Kreyl/HogwartsFlasks/README.md

# HogwartsFlasks
Hogwarts Flasks is a project for realictic models of Hogwarts hourglasses for LARPs and events
You may look at them here https://ostranna.ru/hogwartsflasks (text is at Russian, but photoes are international)
