Kreyl/HogwartsFlasks/(list of files, drawings)

Other design files:
PCB/HogwartsFlasksMain.dsn
