Kreyl/HogwartsFlasks/PCB/HogwartsFlasksMain.kicad_pcb

## KiCad design PCB/HogwartsFlasksMain.kicad_pcb (2019-09-29)

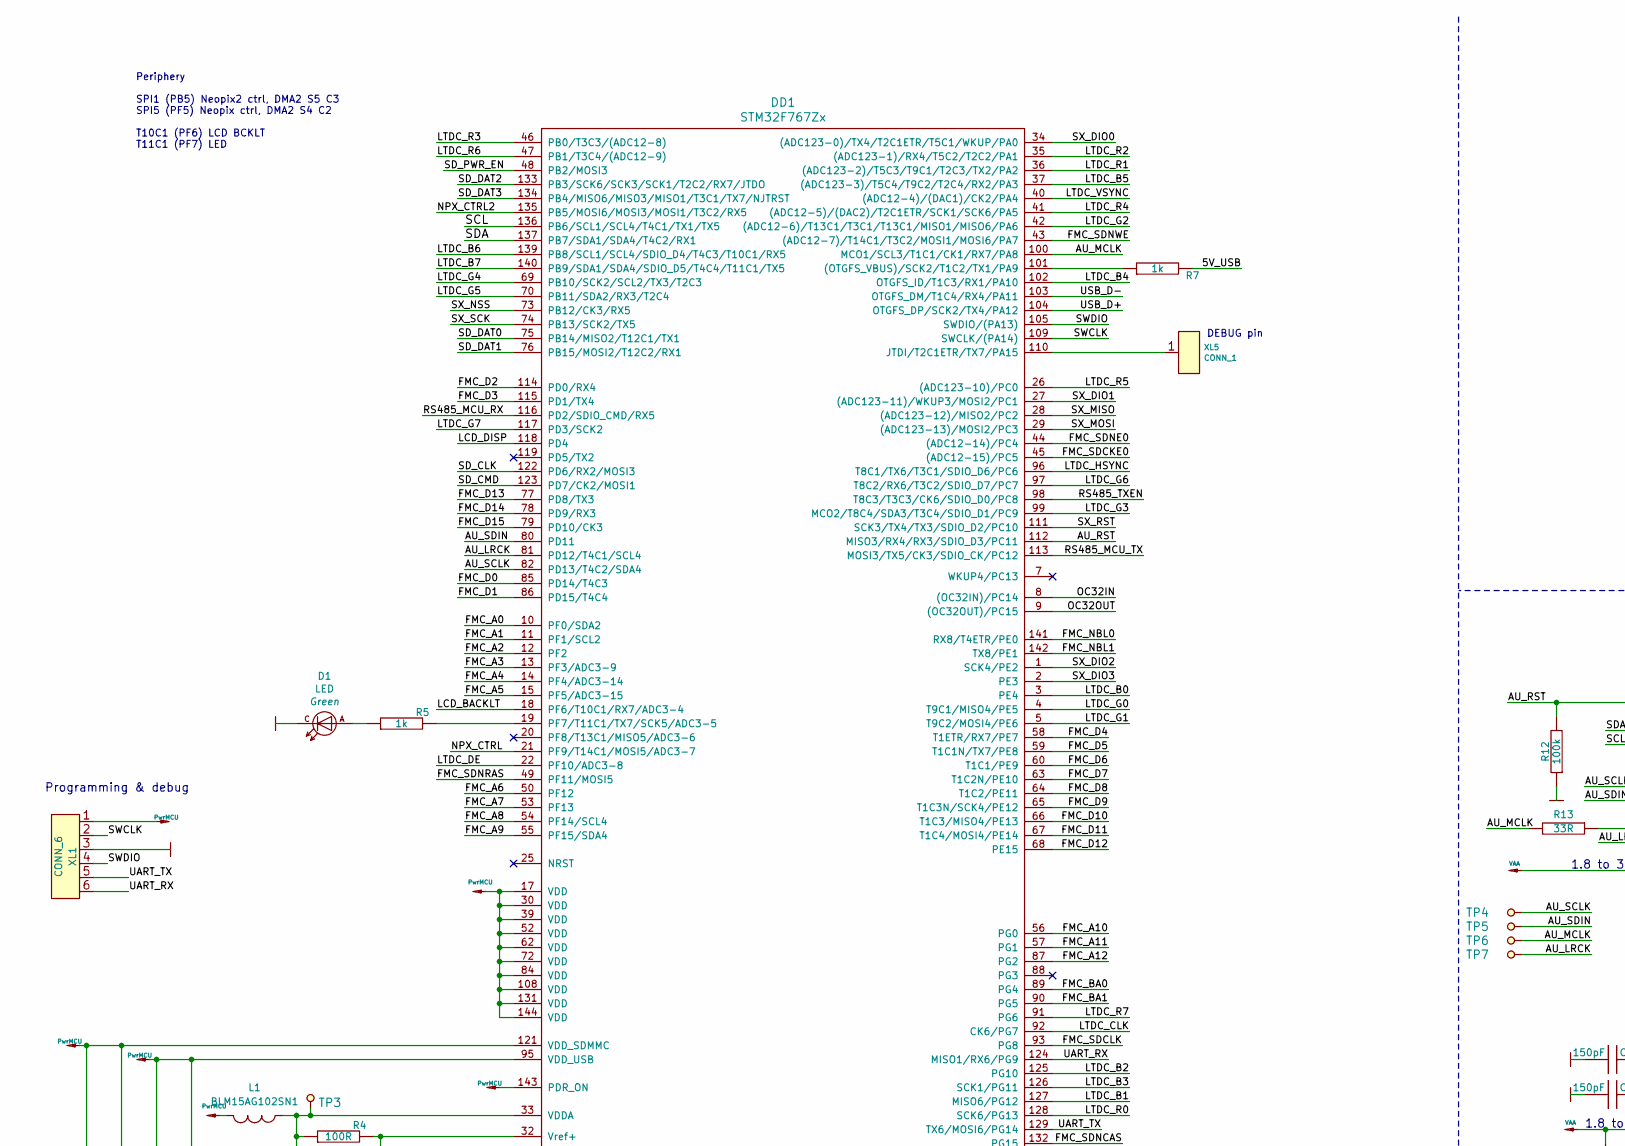
[picture p1: schematic HogwartsFlasksMain.kicad_sch, part in row 1, column 1]

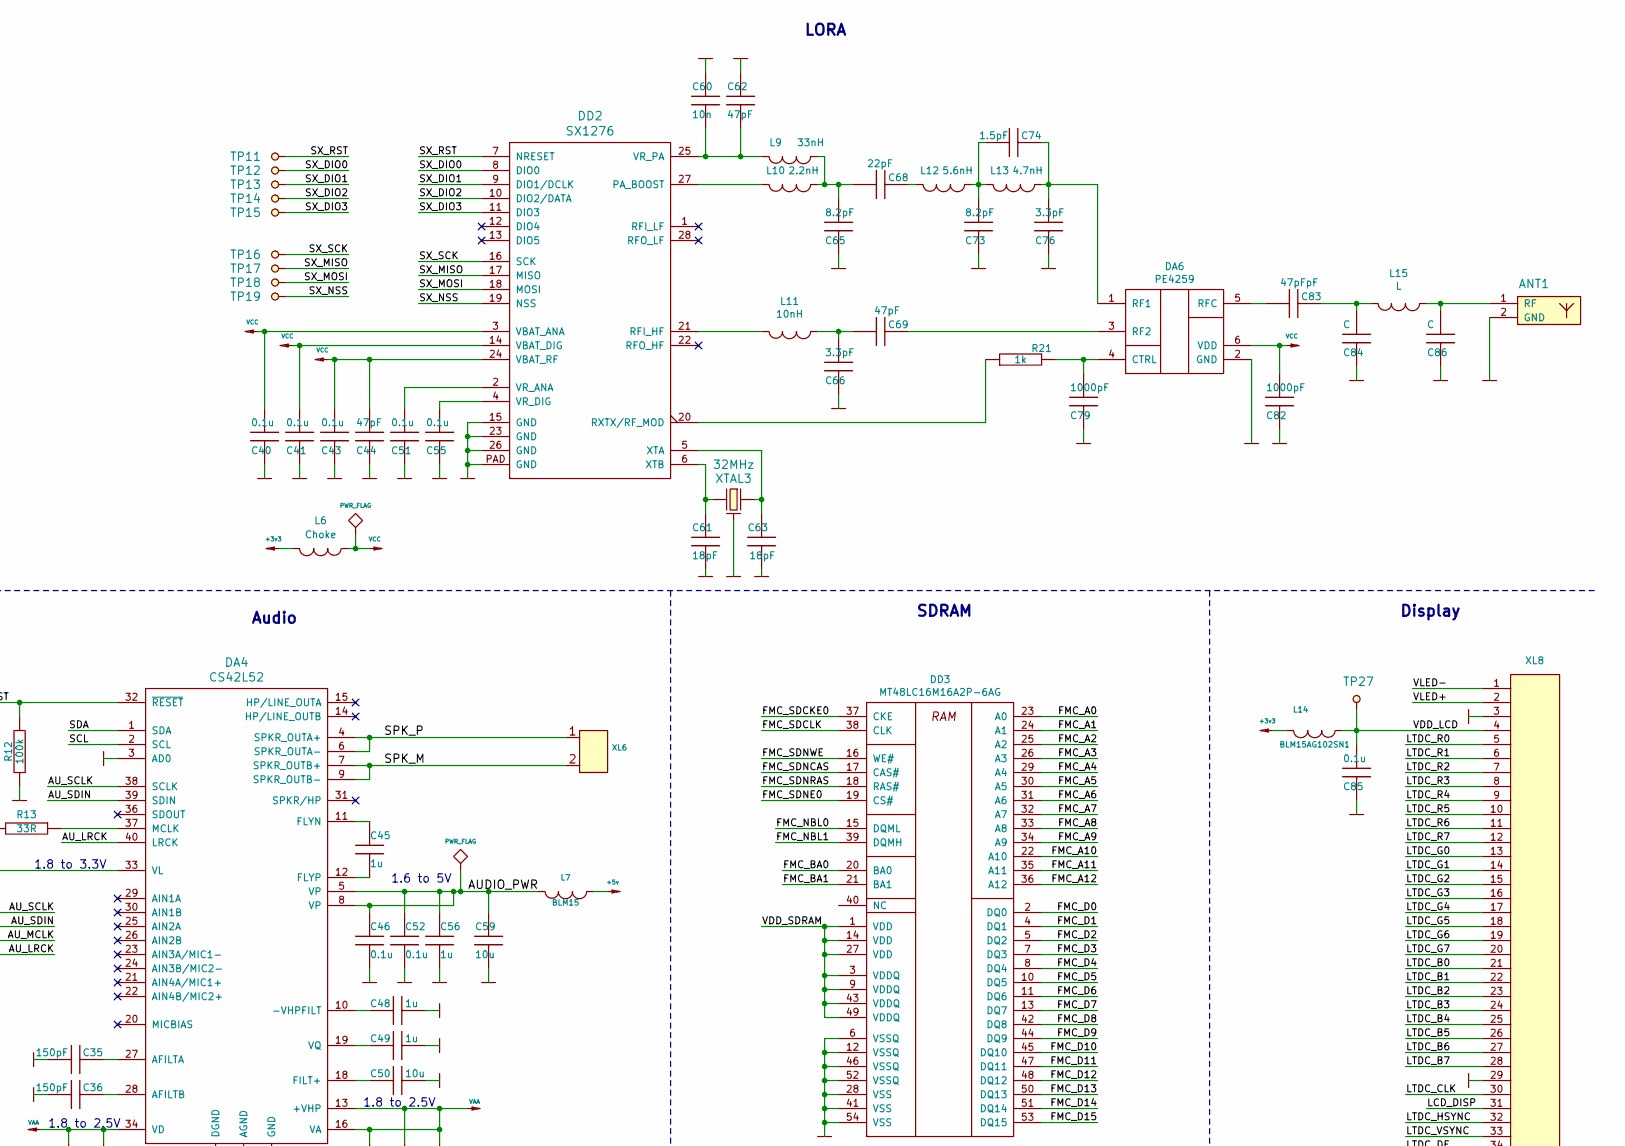
[picture p2: schematic HogwartsFlasksMain.kicad_sch, part in row 1, column 2]

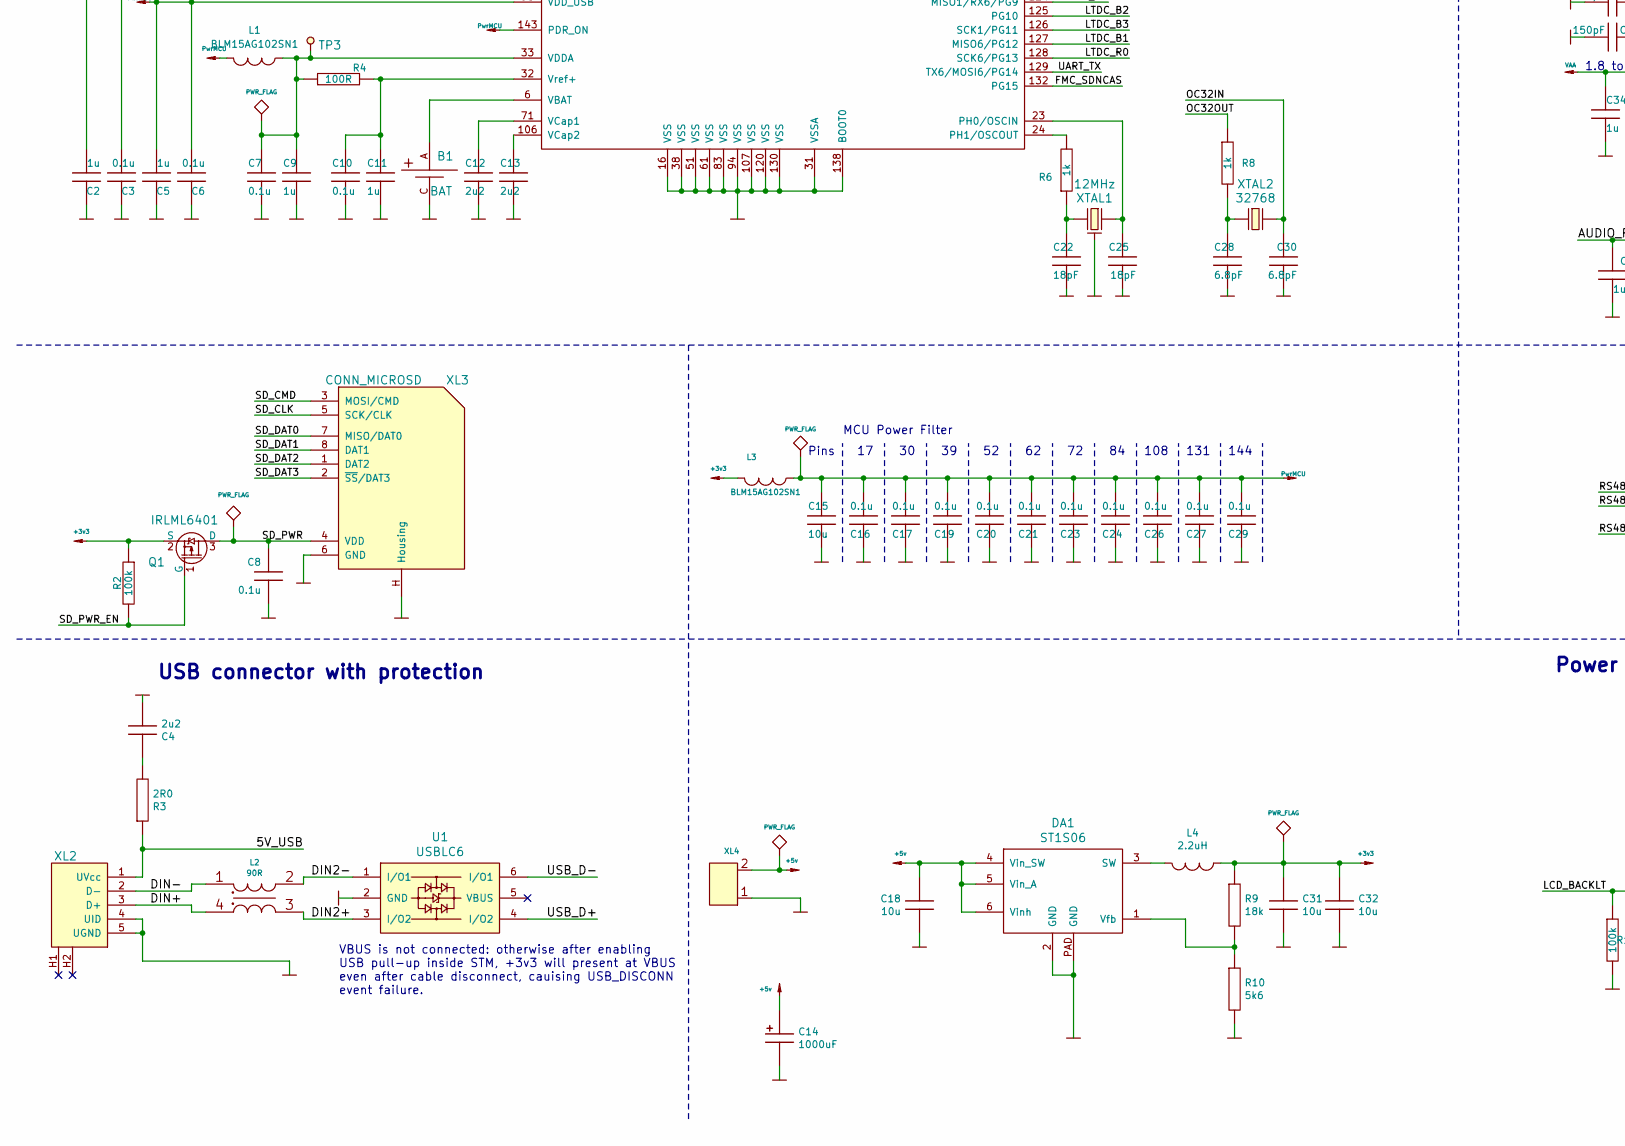
[picture p3: schematic HogwartsFlasksMain.kicad_sch, part in row 2, column 1]

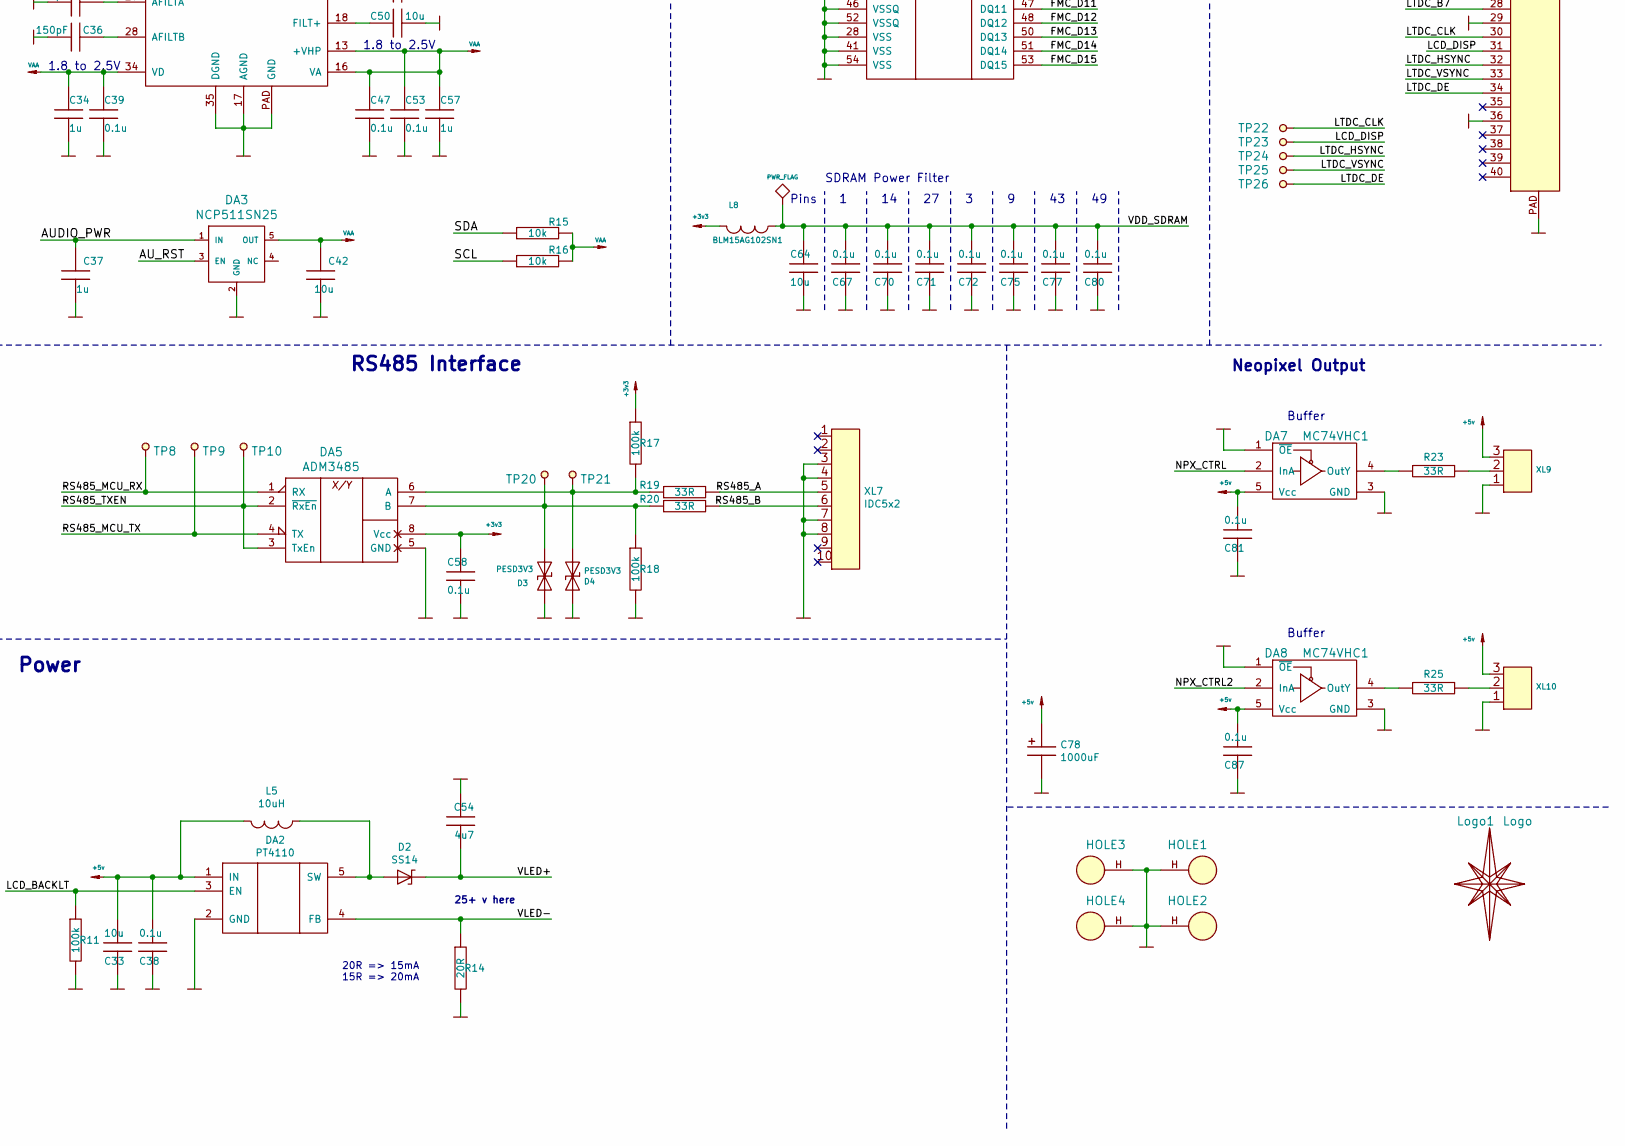
[picture p4: schematic HogwartsFlasksMain.kicad_sch, part in row 2, column 2]

Parts:
ANT1: ANT_GENERAL; ANT_868_IFA_SIMPLEJOY
B1: BAT; BATTERY_CH7410
C2, C5, C9, C11, C34, C37, C45, C48, C49, C56, C57: 1u; CAP_0603_Silks
C3, C6, C7, C8, C10, C16, C17, C19, C20, C21, C23, C24, C26, C27, C29, C38, C39, C46, C47, C52, C53, C58, C67, C70, C71, C72, C75, C77, C80, C81, C85, C87: 0.1u; CAP_0603_Silks
C4, C12, C13: 2u2; CAP_0603_Silks
C14, C78: 1000uF; CAP_10xxR
C15, C18, C31, C32, C33, C42, C50, C59, C64: 10u; CAP_0603_Silks
C22, C25, C61, C63: 18pF; CAP_0603_Silks
C28, C30: 6.8pF; CAP_0603_Silks
C35, C36: 150pF; CAP_0603_Silks
C40, C41, C43, C51, C55: 0.1u; CAP_0402
C44, C62, C69: 47pF; CAP_0402
C54: 4u7; CAP_0805
C60: 10n; CAP_0402
C65, C73: 8.2pF; CAP_0402
C66, C76: 3.3pF; CAP_0402
C68: 22pF; CAP_0402
C74: 1.5pF; CAP_0402
C79, C82: 1000pF; CAP_0402
C83: 47pFpF; CAP_0402
C84, C86: C; CAP_0402
D1: LED; LED_0603
D2: SS14; SMA_DO214AC
D3, D4: PESD3V3; SOD323
DA1: ST1S06; DFN6_3x3
DA2: PT4110; SOT89-5
DA3: NCP511SN25; SOT23-5
DA4: CS42L52; QFN40
DA5: ADM3485; SO8_150MIL
DA6: PE4259; SC70
DA7, DA8: MC74VHC1; SOT23-5
DD1: STM32F767Zx; QFP-144_20x20_Pitch0.5mm
DD2: SX1276; QFN-28_EP_6x6_Pitch0.65mm
DD3: MT48LC16M16A2P-6AG; TSSOP54_400MIL_P08
HOLE1, HOLE2, HOLE3, HOLE4: HOLE_METALLED; Hole3_5_out6mm
L1, L3, L8, L14: BLM15AG102SN1; IND_0402
L2: 90R; DLW21SN
L4: 2.2uH; IND_SRN2512
L5: 10uH; IND_1210_LQH32C
L6: Choke; IND_0402
L7: BLM15; IND_0402
L9: 33nH; IND_0402
L10: 2.2nH; IND_0402
L11: 10nH; IND_0402
L12: 5.6nH; IND_0402
L13: 4.7nH; IND_0402
L15: L; IND_0402
Logo1: Logo; Ostranna_12d7_10d1
Q1: IRLML6401; SOT23-3
R2, R11, R12, R17, R18: 100k; RES_0603
R3: 2R0; RES_0603
R4: 100R; RES_0603
R5, R6, R7, R8, R21: 1k; RES_0603
R9: 18k; RES_0603
R10: 5k6; RES_0603
R13, R19, R20, R23, R25: 33R; RES_0603
R14: 20R; RES_0603
R15, R16: 10k; RES_0603
TP3, TP4, TP5, TP6, TP7, TP8, TP9, TP10, TP11, TP12, TP13, TP14, TP15, TP16, TP17, TP18, TP19, TP20, TP21, TP22, TP23, TP24, TP25, TP26, TP27: TESTPOINT; TESTPOINT_1MM
U1: USBLC6; SOT23-6
XL1: CONN_6; PLS-6_LOCK
XL2: USB_MICRO_2H; USBmicro_MOLEX_1050170001
XL3: CONN_MICROSD; MICROSD_CAP_FIX05A
XL4: CONN_2; TermiBlockHeader_508_x2_R
XL5: CONN_1; PLS-1Rnd
XL6: CONN_2; W02_Pitch_2d54
XL7: IDC5x2; IDC-Header_2x5_P2.54mm_Vertical
XL8: CONN_40; FFC_0d5x40_flip
XL9, XL10: CONN_3; SLD_3_2D5
XTAL1: 12MHz; 03225C4
XTAL2: 32768; 03215C2
XTAL3: 32MHz; 03225C4

Connections:
+3v3: C31.1, C32.1, C58.2, DA5.8 (Vcc), L3.2, L4.2, L6.2, L8.2, L14.2, Q1.2 (S), R2.1, R9.1, R17.1
+5v: C14.1, C18.1, C33.1, C38.1, C78.1, C81.1, C87.1, DA1.4 (Vin_SW), DA1.5 (Vin_A), DA1.6 (Vinh), DA2.1 (IN), DA7.5 (Vcc), DA8.5 (Vcc), L5.1, L7.2, XL4.2 (PM), XL9.3, XL10.3
/5V_USB: R3.1, R7.2, XL2.1 (UVcc)
/AUDIO_PWR: C37.1, C46.1, C52.1, C56.1, C59.2, DA3.1 (IN), DA4.5 (VP), DA4.8 (VP), L7.1
/AU_LRCK: DA4.40 (LRCK), DD1.81 (PD12/T4C1/SCL4), TP7.1
/AU_MCLK: DD1.100 (MCO1/SCL3/T1C1/CK1/RX7/PA8), R13.2, TP6.1
/AU_RST: DA3.3 (EN), DA4.32 (~RESET), DD1.112 (MISO3/RX4/RX3/SDIO_D3/PC11), R12.2
/AU_SCLK: DA4.38 (SCLK), DD1.82 (PD13/T4C2/SDA4), TP4.1
/AU_SDIN: DA4.39 (SDIN), DD1.80 (PD11), TP5.1
/DIN2+: L2.3, U1.3 (I/O2)
/DIN2-: L2.2, U1.1 (I/O1)
/DIN+: L2.4, XL2.3 (D+)
/DIN-: L2.1, XL2.2 (D-)
/FMC_A0: DD1.10 (PF0/SDA2), DD3.23 (A0)
/FMC_A1: DD1.11 (PF1/SCL2), DD3.24 (A1)
/FMC_A2: DD1.12 (PF2), DD3.25 (A2)
/FMC_A3: DD1.13 (PF3/ADC3-9), DD3.26 (A3)
/FMC_A4: DD1.14 (PF4/ADC3-14), DD3.29 (A4)
/FMC_A5: DD1.15 (PF5/ADC3-15), DD3.30 (A5)
/FMC_A6: DD1.50 (PF12), DD3.31 (A6)
/FMC_A7: DD1.53 (PF13), DD3.32 (A7)
/FMC_A8: DD1.54 (PF14/SCL4), DD3.33 (A8)
/FMC_A9: DD1.55 (PF15/SDA4), DD3.34 (A9)
/FMC_A10: DD1.56 (PG0), DD3.22 (A10)
/FMC_A11: DD1.57 (PG1), DD3.35 (A11)
/FMC_A12: DD1.87 (PG2), DD3.36 (A12)
/FMC_BA0: DD1.89 (PG4), DD3.20 (BA0)
/FMC_BA1: DD1.90 (PG5), DD3.21 (BA1)
/FMC_D0: DD1.85 (PD14/T4C3), DD3.2 (DQ0)
/FMC_D1: DD1.86 (PD15/T4C4), DD3.4 (DQ1)
/FMC_D2: DD1.114 (PD0/RX4), DD3.5 (DQ2)
/FMC_D3: DD1.115 (PD1/TX4), DD3.7 (DQ3)
/FMC_D4: DD1.58 (T1ETR/RX7/PE7), DD3.8 (DQ4)
/FMC_D5: DD1.59 (T1C1N/TX7/PE8), DD3.10 (DQ5)
/FMC_D6: DD1.60 (T1C1/PE9), DD3.11 (DQ6)
/FMC_D7: DD1.63 (T1C2N/PE10), DD3.13 (DQ7)
/FMC_D8: DD1.64 (T1C2/PE11), DD3.42 (DQ8)
/FMC_D9: DD1.65 (T1C3N/SCK4/PE12), DD3.44 (DQ9)
/FMC_D10: DD1.66 (T1C3/MISO4/PE13), DD3.45 (DQ10)
/FMC_D11: DD1.67 (T1C4/MOSI4/PE14), DD3.47 (DQ11)
/FMC_D12: DD1.68 (PE15), DD3.48 (DQ12)
/FMC_D13: DD1.77 (PD8/TX3), DD3.50 (DQ13)
/FMC_D14: DD1.78 (PD9/RX3), DD3.51 (DQ14)
/FMC_D15: DD1.79 (PD10/CK3), DD3.53 (DQ15)
/FMC_NBL0: DD1.141 (RX8/T4ETR/PE0), DD3.15 (DQML)
/FMC_NBL1: DD1.142 (TX8/PE1), DD3.39 (DQMH)
/FMC_SDCKE0: DD1.45 ((ADC12-15)/PC5), DD3.37 (CKE)
/FMC_SDCLK: DD1.93 (PG8), DD3.38 (CLK)
/FMC_SDNCAS: DD1.132 (PG15), DD3.17 (CAS#)
/FMC_SDNE0: DD1.44 ((ADC12-14)/PC4), DD3.19 (CS#)
/FMC_SDNRAS: DD1.49 (PF11/MOSI5), DD3.18 (RAS#)
/FMC_SDNWE: DD1.43 ((ADC12-7)/T14C1/T3C2/MOSI1/MOSI6/PA7), DD3.16 (WE#)
/LCD_BACKLT: DA2.3 (EN), DD1.18 (PF6/T10C1/RX7/ADC3-4), R11.1
/LCD_DISP: DD1.118 (PD4), TP23.1, XL8.31
/LTDC_B0: DD1.3 (PE4), XL8.21
/LTDC_B1: DD1.127 (MISO6/PG12), XL8.22
/LTDC_B2: DD1.125 (PG10), XL8.23
/LTDC_B3: DD1.126 (SCK1/PG11), XL8.24
/LTDC_B4: DD1.102 (OTGFS_ID/T1C3/RX1/PA10), XL8.25
/LTDC_B5: DD1.37 ((ADC123-3)/T5C4/T9C2/T2C4/RX2/PA3), XL8.26
/LTDC_B6: DD1.139 (PB8/SCL1/SCL4/SDIO_D4/T4C3/T10C1/RX5), XL8.27
/LTDC_B7: DD1.140 (PB9/SDA1/SDA4/SDIO_D5/T4C4/T11C1/TX5), XL8.28
/LTDC_CLK: DD1.92 (CK6/PG7), TP22.1, XL8.30
/LTDC_DE: DD1.22 (PF10/ADC3-8), TP26.1, XL8.34
/LTDC_G0: DD1.4 (T9C1/MISO4/PE5), XL8.13
/LTDC_G1: DD1.5 (T9C2/MOSI4/PE6), XL8.14
/LTDC_G2: DD1.42 ((ADC12-6)/T13C1/T3C1/T13C1/MISO1/MISO6/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), XL8.15
/LTDC_G3: DD1.99 (MCO2/T8C4/SDA3/T3C4/SDIO_D1/PC9), XL8.16
/LTDC_G4: DD1.69 (PB10/SCK2/SCL2/TX3/T2C3), XL8.17
/LTDC_G5: DD1.70 (PB11/SDA2/RX3/T2C4), XL8.18
/LTDC_G6: DD1.97 (T8C2/RX6/T3C2/SDIO_D7/PC7), XL8.19
/LTDC_G7: DD1.117 (PD3/SCK2), XL8.20
/LTDC_HSYNC: DD1.96 (T8C1/TX6/T3C1/SDIO_D6/PC6), TP24.1, XL8.32
/LTDC_R0: DD1.128 (SCK6/PG13), XL8.5
/LTDC_R1: DD1.36 ((ADC123-2)/T5C3/T9C1/T2C3/TX2/PA2), XL8.6
/LTDC_R2: DD1.35 ((ADC123-1)/RX4/T5C2/T2C2/PA1), XL8.7
/LTDC_R3: DD1.46 (PB0/T3C3/(ADC12-8)), XL8.8
/LTDC_R4: DD1.41 ((ADC12-5)/(DAC2)/T2C1ETR/SCK1/SCK6/PA5), XL8.9
/LTDC_R5: DD1.26 ((ADC123-10)/PC0), XL8.10
/LTDC_R6: DD1.47 (PB1/T3C4/(ADC12-9)), XL8.11
/LTDC_R7: DD1.91 (PG6), XL8.12
/LTDC_VSYNC: DD1.40 ((ADC12-4)/(DAC1)/CK2/PA4), TP25.1, XL8.33
/NPX_CTRL: DA7.2 (InA), DD1.21 (PF9/T14C1/MOSI5/ADC3-7)
/NPX_CTRL2: DA8.2 (InA), DD1.135 (PB5/MOSI6/MOSI3/MOSI1/T3C2/RX5)
/OC32IN: C30.2, DD1.8 ((OC32IN)/PC14), XTAL2.2
/OC32OUT: DD1.9 ((OC32OUT)/PC15), R8.1
/RS485_A: R19.2, XL7.5
/RS485_B: R20.2, XL7.6
/RS485_MCU_RX: DA5.1 (RX), DD1.116 (PD2/SDIO_CMD/RX5), TP8.1
/RS485_MCU_TX: DA5.4 (TX), DD1.113 (MOSI3/TX5/CK3/SDIO_CK/PC12), TP9.1
/RS485_TXEN: DA5.2 (~RxEn), DA5.3 (TxEn), DD1.98 (T8C3/T3C3/CK6/SDIO_D0/PC8), TP10.1
/SCL: DA4.2 (SCL), DD1.136 (PB6/SCL1/SCL4/T4C1/TX1/TX5), R16.1
/SDA: DA4.1 (SDA), DD1.137 (PB7/SDA1/SDA4/T4C2/RX1), R15.1
/SD_CLK: DD1.122 (PD6/RX2/MOSI3), XL3.5 (SCK/CLK)
/SD_CMD: DD1.123 (PD7/CK2/MOSI1), XL3.3 (MOSI/CMD)
/SD_DAT0: DD1.75 (PB14/MISO2/T12C1/TX1), XL3.7 (MISO/DAT0)
/SD_DAT1: DD1.76 (PB15/MOSI2/T12C2/RX1), XL3.8 (DAT1)
/SD_DAT2: DD1.133 (PB3/SCK6/SCK3/SCK1/T2C2/RX7/JTDO), XL3.1 (DAT2)
/SD_DAT3: DD1.134 (PB4/MISO6/MISO3/MISO1/T3C1/TX7/NJTRST), XL3.2 (~SS~/DAT3)
/SD_PWR: C8.1, Q1.3 (D), XL3.4 (VDD)
/SD_PWR_EN: DD1.48 (PB2/MOSI3), Q1.1 (G), R2.2
/SPK_M: DA4.7 (SPKR_OUTB+), DA4.9 (SPKR_OUTB-), XL6.2 (PM)
/SPK_P: DA4.4 (SPKR_OUTA+), DA4.6 (SPKR_OUTA-), XL6.1
/SWCLK: DD1.109 (SWCLK/(PA14)), XL1.2
/SWDIO: DD1.105 (SWDIO/(PA13)), XL1.4
/SX_DIO0: DD1.34 ((ADC123-0)/TX4/T2C1ETR/T5C1/WKUP/PA0), DD2.8 (DIO0), TP12.1
/SX_DIO1: DD1.27 ((ADC123-11)/WKUP3/MOSI2/PC1), DD2.9 (DIO1/DCLK), TP13.1
/SX_DIO2: DD1.1 (SCK4/PE2), DD2.10 (DIO2/DATA), TP14.1
/SX_DIO3: DD1.2 (PE3), DD2.11 (DIO3), TP15.1
/SX_MISO: DD1.28 ((ADC123-12)/MISO2/PC2), DD2.17 (MISO), TP17.1
/SX_MOSI: DD1.29 ((ADC123-13)/MOSI2/PC3), DD2.18 (MOSI), TP18.1
/SX_NSS: DD1.73 (PB12/CK3/RX5), DD2.19 (NSS), TP19.1
/SX_RST: DD1.111 (SCK3/TX4/TX3/SDIO_D2/PC10), DD2.7 (NRESET), TP11.1
/SX_SCK: DD1.74 (PB13/SCK2/TX5), DD2.16 (SCK), TP16.1
/UART_RX: DD1.124 (MISO1/RX6/PG9), XL1.6
/UART_TX: DD1.129 (TX6/MOSI6/PG14), XL1.5
/USB_D+: DD1.104 (OTGFS_DP/SCK2/TX4/PA12), U1.4 (I/O2)
/USB_D-: DD1.103 (OTGFS_DM/T1C4/RX4/PA11), U1.6 (I/O1)
/VDD_LCD: C85.1, L14.1, TP27.1, XL8.4
/VDD_SDRAM: C64.2, C67.1, C70.1, C71.1, C72.1, C75.1, C77.1, C80.1, DD3.1 (VDD), DD3.3 (VDDQ), DD3.9 (VDDQ), DD3.14 (VDD), DD3.27 (VDD), DD3.43 (VDDQ), DD3.49 (VDDQ), L8.1
unnamed: ANT1.1 (RF), C86.1, L15.2
unnamed: B1.A, DD1.6 (VBAT)
unnamed 122: XL2.H1; also elsewhere on the board
unnamed: C4.1, R3.2
unnamed: C7.2, C9.2, DD1.33 (VDDA), L1.1, R4.1, TP3.1
unnamed: C10.2, C11.2, DD1.32 (Vref+), R4.2
unnamed: C12.2, DD1.71 (VCap1)
unnamed: C13.2, DD1.106 (VCap2)
unnamed: C22.1, R6.1, XTAL1.2
unnamed: C25.1, DD1.23 (PH0/OSCIN), XTAL1.1
unnamed: C28.2, R8.2, XTAL2.1
unnamed: C35.2, DA4.27 (AFILTA)
unnamed: C36.2, DA4.28 (AFILTB)
unnamed: C45.1, DA4.11 (FLYN)
unnamed: C45.2, DA4.12 (FLYP)
unnamed: C48.2, DA4.10 (-VHPFILT)
unnamed: C49.2, DA4.19 (VQ)
unnamed: C50.2, DA4.18 (FILT+)
unnamed: C51.1, DD2.2 (VR_ANA)
unnamed: C55.1, DD2.4 (VR_DIG)
unnamed: C60.1, C62.1, DD2.25 (VR_PA), L9.1
unnamed: C61.1, DD2.6 (XTB), XTAL3.2
unnamed: C63.1, DD2.5 (XTA), XTAL3.1
unnamed: C65.1, C68.2, L9.2, L10.2
unnamed: C66.1, C69.2, L11.2
unnamed: C68.1, L12.1
unnamed: C69.1, DA6.3 (RF2)
unnamed: C73.1, C74.2, L12.2, L13.1
unnamed: C74.1, C76.1, DA6.1 (RF1), L13.2
unnamed: C79.1, DA6.4 (CTRL), R21.2
unnamed: C83.1, C84.1, L15.1
unnamed: C83.2, DA6.5 (RFC)
unnamed: D1.A, R5.1
unnamed: D2.A, DA2.5 (SW), L5.2
unnamed: D3.C, DA5.7 (B), R18.1, R20.1, TP20.1
unnamed: D4.C, DA5.6 (A), R17.2, R19.1, TP21.1
unnamed: DA1.1 (Vfb), R9.2, R10.1
unnamed: DA1.3 (SW), L4.1
unnamed: DA4.37 (MCLK), R13.1
unnamed: DA7.4 (OutY), R23.2
unnamed: DA8.4 (OutY), R25.2
unnamed: DD1.19 (PF7/T11C1/TX7/SCK5/ADC3-5), R5.2
unnamed: DD1.24 (PH1/OSCOUT), R6.2
unnamed: DD1.101 ((OTGFS_VBUS)/SCK2/T1C2/TX1/PA9), R7.1
unnamed: DD1.110 (JTDI/T2C1ETR/TX7/PA15), XL5.1
unnamed: DD2.20 (RXTX/RF_MOD), R21.1
unnamed: DD2.21 (RFI_HF), L11.1
unnamed: DD2.27 (PA_BOOST), L10.1
unnamed: R23.1, XL9.2 (PM)
unnamed: R25.1, XL10.2 (PM)
PwrMCU: C2.1, C3.1, C5.1, C6.1, C15.2, C16.1, C17.1, C19.1, C20.1, C21.1, C23.1, C24.1, C26.1, C27.1, C29.1, DD1.17 (VDD), DD1.30 (VDD), DD1.39 (VDD), DD1.52 (VDD), DD1.62 (VDD), DD1.72 (VDD), DD1.84 (VDD), DD1.95 (VDD_USB), DD1.108 (VDD), DD1.121 (VDD_SDMMC), DD1.131 (VDD), DD1.143 (PDR_ON), DD1.144 (VDD), L1.2, L3.1, XL1.1
VAA: C34.1, C39.1, C42.1, C47.1, C53.1, C57.1, DA3.5 (OUT), DA4.13 (+VHP), DA4.16 (VA), DA4.33 (VL), DA4.34 (VD), R15.2, R16.2
VCC: C40.1, C41.1, C43.1, C44.1, C82.1, DA6.6 (VDD), DD2.3 (VBAT_ANA), DD2.14 (VBAT_DIG), DD2.24 (VBAT_RF), L6.1

Notes on the sheet:
Programming & debug
Periphery SPI1 (PB5) Neopix2 ctrl, DMA2 S5 C3 SPI5 (PF5) Neopix ctrl, DMA2 S4 C2 T10C1 (PF6) LCD BCKLT T11C1 (PF7) LED
USB connector with protection
VBUS is not connected: otherwise after enabling USB pull-up inside STM, +3v3 will present at VBUS even after cable disconnect, cauising USB_DISCONN event failure.
Pins
MCU Power Filter
108
131
DEBUG pin
144
1.8 to 3.3V
1.8 to 2.5V
Power
Audio
20R => 15mA 15R => 20mA
1.6 to 5V
25+ v here
RS485 Interface
LORA
SDRAM Power Filter
SDRAM
Neopixel Output
Buffer
Display

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
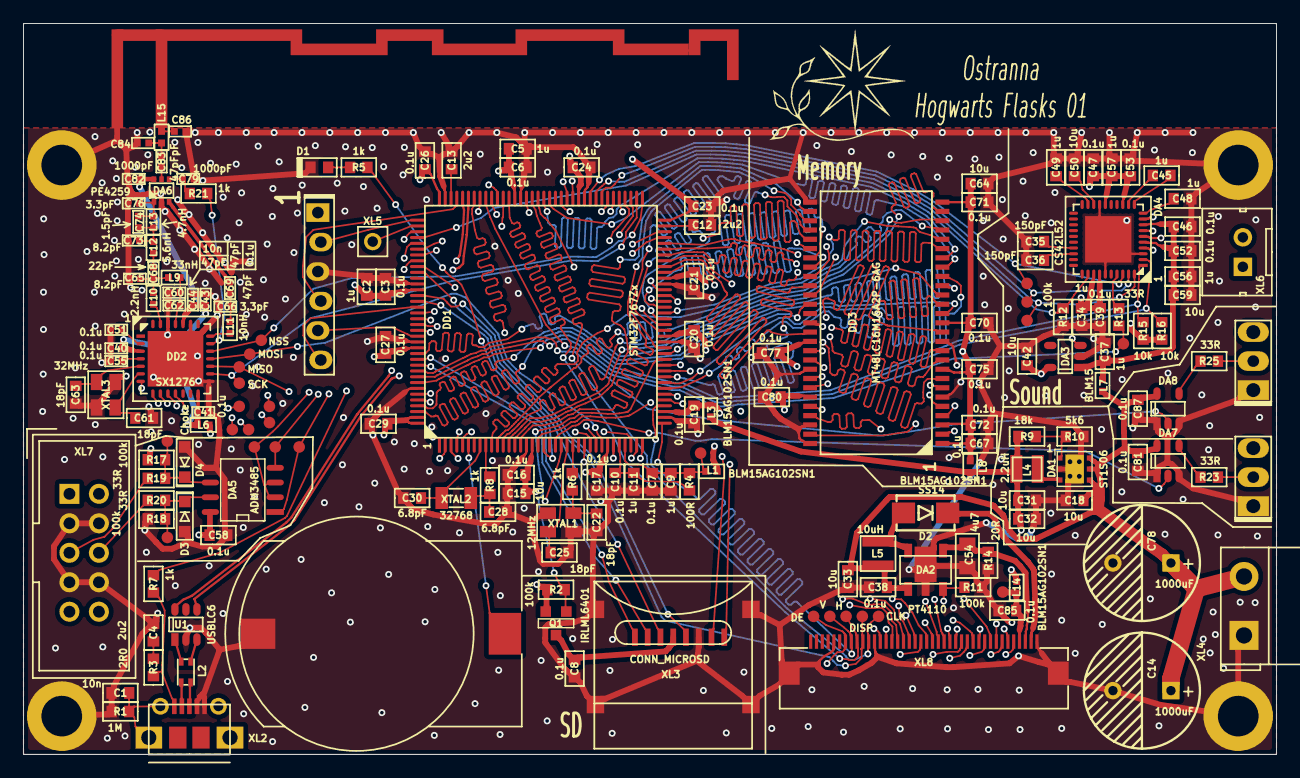
[picture p5: board HogwartsFlasksMain.kicad_pcb from above]

Board: 4 copper layers, 108.0 x 63.0 mm, 187 parts (0 on the bottom side), 176 nets.

Other parts of the board:
C1: 10n; CAP_0603_Silks
R1: 1M; RES_0603

Their connections:
unnamed 122: C1.2, R1.1; also elsewhere on the board
