Kreyl/HogwartsFlasks/FlasksMain_fw/main.cpp

#include "hal.h"
#include "MsgQ.h"
#include "kl_lib.h"
#include "Sequences.h"
#include "uart.h"
#include "shell.h"
#include "led.h"
#include "ws2812b.h"
#include "kl_sd.h"
#include "kl_fs_utils.h"
#include "kl_time.h"
#include "Mirilli.h"
#include "sdram.h"
#include "radio_lvl1.h"
#include "FlasksSnd.h"
#include "Points.h"

#if 1 // =============== Defines ================
// Forever
EvtMsgQ_t<EvtMsg_t, MAIN_EVT_Q_LEN> EvtQMain;
static const UartParams_t CmdUartParams(115200, CMD_UART_PARAMS);
CmdUart_t Uart{CmdUartParams};

static const UartParams_t RS485Params(19200, RS485_PARAMS);
HostUart485_t RS485{RS485Params, RS485_TXEN};

static void ITask();
static void OnCmd(Shell_t *PShell);

LedBlinker_t Led{LED_PIN};
TmrKL_t TmrBckgStop{TIME_MS2I(7200), evtIdBckgStop, tktOneShot};
#endif

#if 1 // ========= Lume =========
static void IndicateNewSecond();
Color_t ClrH(0, 0, 255);
Color_t ClrM(0, 255, 0);

class Hypertime_t {
public:
    void ConvertFromTime() {
        // Hours
        int32_t FH = Time.Curr.H;
        if(FH > 11) FH -= 12;
        if(H != FH) {
            H = FH;
            NewH = true;
        }
        // Minutes
        int32_t S = Time.Curr.M * 60 + Time.Curr.S;
        int32_t FMin = S / 150;    // 150s in one hyperminute (== 2.5 minutes)
        if(M != FMin) {
            M = FMin;
            NewM = true;
        }
    }
    int32_t H, M;
    bool NewH = true, NewM = true;
} Hypertime;
#endif

void main() {
    // ==== Setup clock ====
    Clk.SetCoreClk160MHz();
    Clk.Setup48Mhz();
    // SAI clock: PLLSAI1 Q
    Clk.SetPllSai1QDiv(8, 1); // Q = 2 * 96 / 8 = 24; 24/1 = 24
    Clk.SetSai2ClkSrc(saiclkPllSaiQ);
    FLASH->ACR |= FLASH_ACR_ARTEN; // Enable ART accelerator
    Clk.UpdateFreqValues();

    // ==== Init OS ====
    halInit();
    chSysInit();
    // ==== Init Hard & Soft ====
    SdramInit();
    EvtQMain.Init();
    Uart.Init();
    Printf("\r%S %S\r\n", APP_NAME, XSTRINGIFY(BUILD_TIME));
    Clk.PrintFreqs();

    // Debug LED
    Led.Init();
    Led.StartOrRestart(lsqIdle);

    SD.Init();

    // Time
    BackupSpc::EnableAccess();
    ClrH.DWord32 = BackupSpc::ReadRegister(BCKP_REG_CLRH_INDX);
    ClrM.DWord32 = BackupSpc::ReadRegister(BCKP_REG_CLRM_INDX);
    InitMirilli();
    Time.Init();

    Sound.Init();
    Sound.SetupVolume(81);
    Sound.SetSlotVolume(BACKGROUND_SLOT, 2048);
    Sound.PlayAlive();
    chThdSleepMilliseconds(1535);
    uint32_t Volume = BackupSpc::ReadRegister(BCKP_REG_VOLUME_INDX);
    if(Volume > 100) Volume = 100;
    Sound.SetupVolume(Volume);

    // Points
    Npx.Init();
    Points::Init();
    RS485.Init();

    Radio.Init();

    // ==== Main cycle ====
    ITask();
}

// Sum is used as simple CRC
void SendScreenCmd(Points::Values v) {
    RS485.SendBroadcast(0, 1, "Set", "%d %d %d %d %d", v.grif, v.slyze, v.rave, v.huff, v.Sum());
}

void SendScreenCmdHide() {
    RS485.SendBroadcast(0, 1, "Hide");
}

__noreturn
void ITask() {
    while(true) {
        EvtMsg_t Msg = EvtQMain.Fetch(TIME_INFINITE);
        switch(Msg.ID) {
            case evtIdUartCmdRcvd:
                Led.StartOrRestart(lsqCmd);
                while(((CmdUart_t*)Msg.Ptr)->TryParseRxBuff() == retvOk) OnCmd((Shell_t*)((CmdUart_t*)Msg.Ptr));
                break;

            case evtIdEverySecond:
                IndicateNewSecond();
                break;

            // Points
            case evtIdPointsSet:
                Sound.PlayBackgroundIfNotYet();
                TmrBckgStop.StartOrRestart();
                break;
            case evtIdPointsAdd:
                Sound.PlayAdd(Msg.Value);
                Sound.PlayBackgroundIfNotYet();
                TmrBckgStop.StartOrRestart();
                SendScreenCmd(Points::GetDisplayed());
                break;
            case evtIdPointsRemove:
                Sound.PlayRemove(Msg.Value);
                Sound.PlayBackgroundIfNotYet();
                TmrBckgStop.StartOrRestart();
                SendScreenCmd(Points::GetDisplayed());
                break;
            case evtIdPointsHide:
                SendScreenCmdHide();
                break;
            case evtIdPointsShow:
                SendScreenCmd(Points::GetDisplayed());
                break;

            case evtIdBckgStop:
                Sound.StopBackground();
                break;

            default: break;
        } // switch
    } // while true
}

#if 1 // ============================== Lume ===================================
void IndicateNewSecond() {
    chSysLock();
    Time.GetDateTime();
    Hypertime.ConvertFromTime();
    ResetColorsToOffState(ClrH, ClrM);

    SetTargetClrH(Hypertime.H, ClrH);
    if(Hypertime.M == 0) {
        SetTargetClrM(0, ClrM);
        SetTargetClrM(11, ClrM);
    }
    else {
        uint32_t N = Hypertime.M / 2;
        if(Hypertime.M & 1) { // Odd, single
            SetTargetClrM(N, ClrM);
        }
        else { // Even, couple
            SetTargetClrM(N, ClrM);
            SetTargetClrM(N-1, ClrM);
        }
    }
    chSysUnlock();
    WakeMirilli();
}
#endif

uint8_t CheckAndSetTime(DateTime_t &dt) {
    if(!dt.IsOk()) return retvFail;
    Time.Curr = dt;
    Time.SetDateTime();
    IndicateNewSecond();
    return retvOk;
}

#if 1 // ======================= Command processing ============================
void OnCmd(Shell_t *PShell) {
    Cmd_t *PCmd = &PShell->Cmd;
    // Handle command
    if(PCmd->NameIs("Ping")) PShell->Ok();
    else if(PCmd->NameIs("Version")) PShell->Print("%S %S\r\n", APP_NAME, XSTRINGIFY(BUILD_TIME));
    else if(PCmd->NameIs("mem")) PrintMemoryInfo();

    else if(PCmd->NameIs("Volume")) {
        uint8_t Volume;
        if(PCmd->GetNext<uint8_t>(&Volume) != retvOk) return;
        if(Volume > 100) Volume = 100;
        Sound.SetupVolume(Volume);
        BackupSpc::WriteRegister(BCKP_REG_VOLUME_INDX, Volume);
        PShell->Ok();
    }

    else if(PCmd->NameIs("clr")) {
        Color_t Clr;
        if(PCmd->GetNext<uint8_t>(&Clr.R) != retvOk) { PShell->CmdError(); return; }
        if(PCmd->GetNext<uint8_t>(&Clr.G) != retvOk) { PShell->CmdError(); return; }
        if(PCmd->GetNext<uint8_t>(&Clr.B) != retvOk) { PShell->CmdError(); return; }
        for(int i=0; i<2; i++) Npx.ClrBuf[i] = Clr;
        Npx.SetCurrentColors();
    }

#if 1 // Lume
    else if(PCmd->NameIs("GetTime")) {
        Time.GetDateTime();
        Time.Curr.Print();
    }
    else if(PCmd->NameIs("SetTime")) {
        DateTime_t dt = Time.Curr;
        if(PCmd->GetNext<int32_t>(&dt.Year) != retvOk) return;
        if(PCmd->GetNext<int32_t>(&dt.Month) != retvOk) return;
        if(PCmd->GetNext<int32_t>(&dt.Day) != retvOk) return;
        if(PCmd->GetNext<int32_t>(&dt.H) != retvOk) return;
        if(PCmd->GetNext<int32_t>(&dt.M) != retvOk) return;
        if(CheckAndSetTime(dt) == retvOk) PShell->Print("Result: Ok\r\n");
        else PShell->Print("Result: Fail\r\n");
    }

    // Time speed
    else if(PCmd->NameIs("Fast")) {
        Time.BeFast();
        PShell->Ok();
    }
    else if(PCmd->NameIs("Norm")) {
        Time.BeNormal();
        PShell->Ok();
    }

    // Clock colors
    else if(PCmd->NameIs("ClrH")) {
        Color_t Clr;
        if(PCmd->GetNext<uint8_t>(&Clr.R) != retvOk) { PShell->CmdError(); return; }
        if(PCmd->GetNext<uint8_t>(&Clr.G) != retvOk) { PShell->CmdError(); return; }
        if(PCmd->GetNext<uint8_t>(&Clr.B) != retvOk) { PShell->CmdError(); return; }
        ClrH = Clr;
        BackupSpc::WriteRegister(BCKP_REG_CLRH_INDX, Clr.DWord32);
        PShell->Ok();
    }
    else if(PCmd->NameIs("ClrM")) {
        Color_t Clr;
        if(PCmd->GetNext<uint8_t>(&Clr.R) != retvOk) { PShell->CmdError(); return; }
        if(PCmd->GetNext<uint8_t>(&Clr.G) != retvOk) { PShell->CmdError(); return; }
        if(PCmd->GetNext<uint8_t>(&Clr.B) != retvOk) { PShell->CmdError(); return; }
        ClrM = Clr;
        BackupSpc::WriteRegister(BCKP_REG_CLRM_INDX, Clr.DWord32);
        PShell->Ok();
    }
#endif

    else if(PCmd->NameIs("Set")) {
        Points::Values v;
        if(PCmd->GetArray(v.arr, VALUES_CNT) != retvOk) {
            PShell->Print("Result: Fail\r\n");
            return;
        }
        Points::Set(v);
        PShell->Print("Result: Ok\r\n");
    }

    else if(PCmd->NameIs("Get")) Points::Print();

    else if(PCmd->NameIs("Hide")) {
        Points::Hide();
        SendScreenCmdHide();
        PShell->Ok();
    }
    else if(PCmd->NameIs("Show")) {
        Points::Show();
        SendScreenCmd(Points::GetDisplayed());
        PShell->Ok();
    }


    else if(PCmd->NameIs("help")) {
        PShell->Print("%S %S\r\n", APP_NAME, XSTRINGIFY(BUILD_TIME));
        Printf( "Volume <0..100>\r"
                "SetTime <Year> <Month> <Day> <H> <M>\r"
                "GetTime\r"
                "ClrH <R> <G> <B>  - color of hour miril\r"
                "ClrM <R> <G> <B>  - color of minute miril\r"
                "Set <Grif> <Slyze> <Rave> <Huff> - set points\r"
                "Get - get current points\r"
                "Hide - hide all points\r"
                "Show - show points if hidden\r"
        );
    }

    else {
        Printf("%S\r\n", PCmd->Name);
        PShell->CmdUnknown();
    }
}
#endif
