Kreyl/HogwartsFlasks/PNG/ready/main.cpp

#include "hal.h"
#include "MsgQ.h"
#include "kl_lib.h"
#include "uart.h"
#include "shell.h"
#include "led.h"
#include "Sequences.h"
#include "sdram.h"
#include "lcdtft.h"

#include "LogoOstranna.h"
#include "lodepng.h"

#if 1 // =============== Defines ================
// Forever
EvtMsgQ_t<EvtMsg_t, MAIN_EVT_Q_LEN> EvtQMain;
static const UartParams_t CmdUartParams(115200, CMD_UART_PARAMS);
CmdUart_t Uart{&CmdUartParams};
static void ITask();
static void OnCmd(Shell_t *PShell);

LedBlinker_t Led{LED_PIN};

#endif

int main() {
    // ==== Setup clock ====
    Clk.SetCoreClk80MHz();
//    Clk.Setup48Mhz(2); // SAI R div = 2 => R = 2*96/2 = 96 MHz
//    Clk.SetSaiDivR(8); // LCD_CLK = 96 / 8 = 12MHz
    Clk.Setup48Mhz(3); // SAI R div = 3 => R = 2*96/3 = 64 MHz
    Clk.SetSaiDivR(8); // LCD_CLK = 64 / 8 = 8MHz
    Clk.UpdateFreqValues();

    // ==== Init OS ====
    halInit();
    chSysInit();

    // ==== Init Hard & Soft ====
    SdramInit();
    EvtQMain.Init();
    Uart.Init();
    Printf("\r%S %S\r\n", APP_NAME, XSTRINGIFY(BUILD_TIME));
    Clk.PrintFreqs();

    SdramCheck();

    Led.Init();
    Led.StartOrRestart(lsqIdle);

    LcdInit();


    uint32_t error;
    unsigned char* image = 0;
    unsigned width = 440, height = 234;
    systime_t start = chVTGetSystemTimeX();
    error = lodepng_decode32(&image, &width, &height, (const unsigned char*)LogoOstranna, LOGOOSTRANNA_SZ);
    Printf("W %u; H %u; Time: %u\r", width, height, TIME_I2MS(chVTTimeElapsedSinceX(start)));
    if(error) Printf("error %u: %s\n", error, lodepng_error_text(error));


    LcdDraw(0, 0, (uint32_t*)image, width, height);

    SdramCheck();

    // ==== Main cycle ====
    ITask();
}

//void* lodepng_malloc(size_t size) {
//    void* ptr = malloc(size);
////    Printf("malloc %X; %u; isAligned=%u\r", ptr, size, !(size & 3));
//    Printf("malloc %X; %u\r", ptr, size);
//    return ptr;
//}
//
//void* lodepng_realloc(void* ptr, size_t new_size) {
//    Printf("realloc %X; %u\r", ptr, new_size);
//    return realloc(ptr, new_size);
//}
//
//void lodepng_free(void* ptr) {
//    Printf("free %X\r", ptr);
//    free(ptr);
//}

extern "C"
caddr_t _sbrk(int incr) {
    extern uint8_t __heap_base__;
    extern uint8_t __heap_end__;

    static uint8_t *current_end = NULL;
    uint8_t *current_block_address;

    if (!current_end)
        current_end = &__heap_base__;

    current_block_address = current_end;

    incr = (incr + 3) & (~3);
    if (current_end + incr > &__heap_end__) {
        errno = ENOMEM;
        return (caddr_t) -1;
    }
    current_end += incr;
    return (caddr_t) current_block_address;

}


__noreturn
void ITask() {
    while(true) {
        EvtMsg_t Msg = EvtQMain.Fetch(TIME_INFINITE);
        switch(Msg.ID) {
            case evtIdShellCmd:
                Led.StartOrRestart(lsqCmd);
                OnCmd((Shell_t*)Msg.Ptr);
                ((Shell_t*)Msg.Ptr)->SignalCmdProcessed();
                break;

            default: break;
        } // switch
    } // while true
}

#if 1 // ======================= Command processing ============================
void OnCmd(Shell_t *PShell) {
    Cmd_t *PCmd = &PShell->Cmd;
//    Printf("%S  ", PCmd->Name);

    // Handle command
    if(PCmd->NameIs("Ping")) PShell->Ack(retvOk);
    else if(PCmd->NameIs("Version")) PShell->Print("%S %S\r\n", APP_NAME, XSTRINGIFY(BUILD_TIME));
    else if(PCmd->NameIs("mem")) PrintMemoryInfo();

    else if(PCmd->NameIs("Paint")) {
        uint32_t Left, Top, Right, Bottom;
        uint32_t A, R, G, B;
        if(PCmd->GetNext<uint32_t>(&Left) != retvOk) { PShell->Ack(retvBadValue); return; }
        if(PCmd->GetNext<uint32_t>(&Top) != retvOk) { PShell->Ack(retvBadValue); return; }
        if(PCmd->GetNext<uint32_t>(&Right) != retvOk) { PShell->Ack(retvBadValue); return; }
        if(PCmd->GetNext<uint32_t>(&Bottom) != retvOk) { PShell->Ack(retvBadValue); return; }
        if(PCmd->GetNext<uint32_t>(&A) != retvOk) { PShell->Ack(retvBadValue); return; }
        if(PCmd->GetNext<uint32_t>(&R) != retvOk) { PShell->Ack(retvBadValue); return; }
        if(PCmd->GetNext<uint32_t>(&G) != retvOk) { PShell->Ack(retvBadValue); return; }
        if(PCmd->GetNext<uint32_t>(&B) != retvOk) { PShell->Ack(retvBadValue); return; }
        LcdPaintL1(Left, Top, Right, Bottom, A, R, G, B);
        PShell->Ack(retvOk);
    }


    else if(PCmd->NameIs("WR")) {
        uint32_t Addr, Value;
        if(PCmd->GetNext<uint32_t>(&Addr) != retvOk) { PShell->Ack(retvBadValue); return; }
        if(PCmd->GetNext<uint32_t>(&Value) != retvOk) { PShell->Ack(retvBadValue); return; }
        *(volatile uint32_t*)Addr = Value;
        PShell->Ack(retvOk);
    }

    else if(PCmd->NameIs("RD")) {
        uint32_t Addr, Value;
        if(PCmd->GetNext<uint32_t>(&Addr) != retvOk) { PShell->Ack(retvBadValue); return; }
        Value = *(volatile uint32_t*)Addr;
        Printf("%X\r", Value);
    }

    else if(PCmd->NameIs("chk")) {
        SdramCheck();
    }

    else {
        Printf("%S\r\n", PCmd->Name);
        PShell->Ack(retvCmdUnknown);
    }
}
#endif
