Kreyl/HogwartsFlasks/FlasksMain_fw/os/hal/hal_sdc_lld.c

/*
    ChibiOS - Copyright (C) 2006..2018 Giovanni Di Sirio

    Licensed under the Apache License, Version 2.0 (the "License");
    you may not use this file except in compliance with the License.
    You may obtain a copy of the License at

        http://www.apache.org/licenses/LICENSE-2.0

    Unless required by applicable law or agreed to in writing, software
    distributed under the License is distributed on an "AS IS" BASIS,
    WITHOUT WARRANTIES OR CONDITIONS OF ANY KIND, either express or implied.
    See the License for the specific language governing permissions and
    limitations under the License.
*/

/**
 * @file    SDMMCv1/hal_sdc_lld.c
 * @brief   STM32 SDC subsystem low level driver source.
 *
 * @addtogroup SDC
 * @{
 */

#include <string.h>

#include "hal.h"

#if HAL_USE_SDC || defined(__DOXYGEN__)

#if !defined(STM32_SDMMCCLK)
#define STM32_SDMMC2CLK  48000000
#endif

/*===========================================================================*/
/* Driver local definitions.                                                 */
/*===========================================================================*/

#define SDMMC_ICR_ALL_FLAGS                                                 \
  (SDMMC_ICR_CCRCFAILC | SDMMC_ICR_DCRCFAILC |                              \
   SDMMC_ICR_CTIMEOUTC | SDMMC_ICR_DTIMEOUTC |                              \
   SDMMC_ICR_TXUNDERRC | SDMMC_ICR_RXOVERRC  |                              \
   SDMMC_ICR_CMDRENDC  | SDMMC_ICR_CMDSENTC  |                              \
   SDMMC_ICR_DATAENDC  | SDMMC_ICR_DBCKENDC  |                              \
   SDMMC_ICR_SDIOITC)

#define SDMMC_STA_ERROR_MASK                                                \
  (SDMMC_STA_CCRCFAIL | SDMMC_STA_DCRCFAIL |                                \
   SDMMC_STA_CTIMEOUT | SDMMC_STA_DTIMEOUT |                                \
   SDMMC_STA_TXUNDERR | SDMMC_STA_RXOVERR)

#define SDMMC_CLKDIV_HS         (2 - 2)
#define SDMMC_CLKDIV_LS         (120 - 2)

#define SDMMC1_WRITE_TIMEOUT                                                \
  (((STM32_SDMMC1CLK / (SDMMC_CLKDIV_HS + 2)) / 1000) *                     \
   STM32_SDC_SDMMC_WRITE_TIMEOUT)
#define SDMMC1_READ_TIMEOUT                                                 \
  (((STM32_SDMMC1CLK / (SDMMC_CLKDIV_HS + 2)) / 1000) *                     \
   STM32_SDC_SDMMC_READ_TIMEOUT)

#define SDMMC2_WRITE_TIMEOUT                                                \
  (((STM32_SDMMC2CLK / (SDMMC_CLKDIV_HS + 2)) / 1000) *                     \
   STM32_SDC_SDMMC_WRITE_TIMEOUT)
#define SDMMC2_READ_TIMEOUT                                                 \
  (((STM32_SDMMC2CLK / (SDMMC_CLKDIV_HS + 2)) / 1000) *                     \
   STM32_SDC_SDMMC_READ_TIMEOUT)

#define SDMMC1_DMA_CHANNEL                                                  \
  STM32_DMA_GETCHANNEL(STM32_SDC_SDMMC1_DMA_STREAM,                         \
                       STM32_SDC_SDMMC1_DMA_CHN)

#define SDMMC2_DMA_CHANNEL                                                  \
  STM32_DMA_GETCHANNEL(STM32_SDC_SDMMC2_DMA_STREAM,                         \
                       STM32_SDC_SDMMC2_DMA_CHN)

/*===========================================================================*/
/* Driver exported variables.                                                */
/*===========================================================================*/

/** @brief SDCD1 driver identifier.*/
#if STM32_SDC_USE_SDMMC1 || defined(__DOXYGEN__)
SDCDriver SDCD1;
#endif

/** @brief SDCD2 driver identifier.*/
#if STM32_SDC_USE_SDMMC2 || defined(__DOXYGEN__)
SDCDriver SDCD2;
#endif

/*===========================================================================*/
/* Driver local variables and types.                                         */
/*===========================================================================*/

/**
 * @brief   SDIO default configuration.
 */
static const SDCConfig sdc_default_cfg = {
  SDC_MODE_4BIT
};

/*===========================================================================*/
/* Driver local functions.                                                   */
/*===========================================================================*/

/**
 * @brief   Prepares to handle read transaction.
 * @details Designed for read special registers from card.
 *
 * @param[in] sdcp      pointer to the @p SDCDriver object
 * @param[out] buf      pointer to the read buffer
 * @param[in] bytes     number of bytes to read
 *
 * @return              The operation status.
 * @retval HAL_SUCCESS  operation succeeded.
 * @retval HAL_FAILED   operation failed.
 *
 * @notapi
 */
static bool sdc_lld_prepare_read_bytes(SDCDriver *sdcp,
                                       uint8_t *buf, uint32_t bytes) {
  osalDbgCheck(bytes < 0x1000000);

  sdcp->sdmmc->DTIMER = sdcp->rtmo;

  /* Checks for errors and waits for the card to be ready for reading.*/
  if (_sdc_wait_for_transfer_state(sdcp))
    return HAL_FAILED;

  /* Prepares the DMA channel for writing.*/
  dmaStreamSetMemory0(sdcp->dma, buf);
  dmaStreamSetTransactionSize(sdcp->dma, bytes / sizeof (uint32_t));
  dmaStreamSetMode(sdcp->dma, sdcp->dmamode | STM32_DMA_CR_DIR_P2M);
  dmaStreamEnable(sdcp->dma);

  /* Setting up data transfer.*/
  sdcp->sdmmc->ICR   = SDMMC_ICR_ALL_FLAGS;
  sdcp->sdmmc->MASK  = SDMMC_MASK_DCRCFAILIE |
                       SDMMC_MASK_DTIMEOUTIE |
                       SDMMC_MASK_RXOVERRIE |
                       SDMMC_MASK_DATAENDIE;
  sdcp->sdmmc->DLEN  = bytes;

  /* Transaction starts just after DTEN bit setting.*/
  sdcp->sdmmc->DCTRL = SDMMC_DCTRL_DTDIR |
                       SDMMC_DCTRL_DTMODE |   /* Multibyte data transfer.*/
                       SDMMC_DCTRL_DMAEN |
                       SDMMC_DCTRL_DTEN;

  return HAL_SUCCESS;
}

/**
 * @brief   Prepares card to handle read transaction.
 *
 * @param[in] sdcp      pointer to the @p SDCDriver object
 * @param[in] startblk  first block to read
 * @param[in] n         number of blocks to read
 * @param[in] resp      pointer to the response buffer
 *
 * @return              The operation status.
 * @retval HAL_SUCCESS  operation succeeded.
 * @retval HAL_FAILED   operation failed.
 *
 * @notapi
 */
static bool sdc_lld_prepare_read(SDCDriver *sdcp, uint32_t startblk,
                                 uint32_t n, uint32_t *resp) {

  /* Driver handles data in 512 bytes blocks (just like HC cards). But if we
     have not HC card than we must convert address from blocks to bytes.*/
  if (!(sdcp->cardmode & SDC_MODE_HIGH_CAPACITY))
    startblk *= MMCSD_BLOCK_SIZE;

  if (n > 1) {
    /* Send read multiple blocks command to card.*/
    if (sdc_lld_send_cmd_short_crc(sdcp, MMCSD_CMD_READ_MULTIPLE_BLOCK,
                                   startblk, resp) || MMCSD_R1_ERROR(resp[0]))
      return HAL_FAILED;
  }
  else {
    /* Send read single block command.*/
    if (sdc_lld_send_cmd_short_crc(sdcp, MMCSD_CMD_READ_SINGLE_BLOCK,
                                   startblk, resp) || MMCSD_R1_ERROR(resp[0]))
      return HAL_FAILED;
  }

  return HAL_SUCCESS;
}

/**
 * @brief   Prepares card to handle write transaction.
 *
 * @param[in] sdcp      pointer to the @p SDCDriver object
 * @param[in] startblk  first block to read
 * @param[in] n         number of blocks to write
 * @param[in] resp      pointer to the response buffer
 *
 * @return              The operation status.
 * @retval HAL_SUCCESS  operation succeeded.
 * @retval HAL_FAILED   operation failed.
 *
 * @notapi
 */
static bool sdc_lld_prepare_write(SDCDriver *sdcp, uint32_t startblk,
                                  uint32_t n, uint32_t *resp) {

  /* Driver handles data in 512 bytes blocks (just like HC cards). But if we
     have not HC card than we must convert address from blocks to bytes.*/
  if (!(sdcp->cardmode & SDC_MODE_HIGH_CAPACITY))
    startblk *= MMCSD_BLOCK_SIZE;

  if (n > 1) {
    /* Write multiple blocks command.*/
    if (sdc_lld_send_cmd_short_crc(sdcp, MMCSD_CMD_WRITE_MULTIPLE_BLOCK,
                                   startblk, resp) || MMCSD_R1_ERROR(resp[0]))
      return HAL_FAILED;
  }
  else {
    /* Write single block command.*/
    if (sdc_lld_send_cmd_short_crc(sdcp, MMCSD_CMD_WRITE_BLOCK,
                                   startblk, resp) || MMCSD_R1_ERROR(resp[0]))
      return HAL_FAILED;
  }

  return HAL_SUCCESS;
}

/**
 * @brief   Wait end of data transaction and performs finalizations.
 *
 * @param[in] sdcp      pointer to the @p SDCDriver object
 * @param[in] n         number of blocks in transaction
 * @param[in] resp      pointer to the response buffer
 *
 * @return              The operation status.
 * @retval HAL_SUCCESS  operation succeeded.
 * @retval HAL_FAILED   operation failed.
 */
static bool sdc_lld_wait_transaction_end(SDCDriver *sdcp, uint32_t n,
                                         uint32_t *resp) {

  /* Note the mask is checked before going to sleep because the interrupt
     may have occurred before reaching the critical zone.*/
  osalSysLock();
  if (sdcp->sdmmc->MASK != 0)
    osalThreadSuspendS(&sdcp->thread);
  if ((sdcp->sdmmc->STA & SDMMC_STA_DATAEND) == 0) {
    osalSysUnlock();
    return HAL_FAILED;
  }

  /* Waits for transfer completion at DMA level, then the stream is
     disabled and cleared.*/
  dmaWaitCompletion(sdcp->dma);

  sdcp->sdmmc->ICR = SDMMC_ICR_ALL_FLAGS;
  sdcp->sdmmc->DCTRL = 0;
  osalSysUnlock();

  /* Finalize transaction.*/
  if (n > 1)
    return sdc_lld_send_cmd_short_crc(sdcp, MMCSD_CMD_STOP_TRANSMISSION, 0, resp);

  return HAL_SUCCESS;
}

/**
 * @brief   Gets SDC errors.
 *
 * @param[in] sdcp      pointer to the @p SDCDriver object
 * @param[in] sta       value of the STA register
 *
 * @notapi
 */
static void sdc_lld_collect_errors(SDCDriver *sdcp, uint32_t sta) {
  uint32_t errors = SDC_NO_ERROR;

  if (sta & SDMMC_STA_CCRCFAIL)
    errors |= SDC_CMD_CRC_ERROR;
  if (sta & SDMMC_STA_DCRCFAIL)
    errors |= SDC_DATA_CRC_ERROR;
  if (sta & SDMMC_STA_CTIMEOUT)
    errors |= SDC_COMMAND_TIMEOUT;
  if (sta & SDMMC_STA_DTIMEOUT)
    errors |= SDC_DATA_TIMEOUT;
  if (sta & SDMMC_STA_TXUNDERR)
    errors |= SDC_TX_UNDERRUN;
  if (sta & SDMMC_STA_RXOVERR)
    errors |= SDC_RX_OVERRUN;
/*  if (sta & SDMMC_STA_STBITERR)
    errors |= SDC_STARTBIT_ERROR;*/

  sdcp->errors |= errors;
}

/**
 * @brief   Performs clean transaction stopping in case of errors.
 *
 * @param[in] sdcp      pointer to the @p SDCDriver object
 * @param[in] n         number of blocks in transaction
 * @param[in] resp      pointer to the response buffer
 *
 * @notapi
 */
static void sdc_lld_error_cleanup(SDCDriver *sdcp,
                                  uint32_t n,
                                  uint32_t *resp) {
  uint32_t sta = sdcp->sdmmc->STA;

  dmaStreamDisable(sdcp->dma);
  sdcp->sdmmc->ICR   = SDMMC_ICR_ALL_FLAGS;
  sdcp->sdmmc->MASK  = 0;
  sdcp->sdmmc->DCTRL = 0;
  sdc_lld_collect_errors(sdcp, sta);

  if (n > 1)
    sdc_lld_send_cmd_short_crc(sdcp, MMCSD_CMD_STOP_TRANSMISSION, 0, resp);
}

/*===========================================================================*/
/* Driver interrupt handlers.                                                */
/*===========================================================================*/

/**
 * @brief   SDMMC1 IRQ handler.
 * @details It just wakes transaction thread, errors handling is performed in
 *          there.
 *
 * @isr
 */
#if STM32_SDC_USE_SDMMC1 || defined(__DOXYGEN__)
OSAL_IRQ_HANDLER(STM32_SDMMC1_HANDLER) {

  OSAL_IRQ_PROLOGUE();

  osalSysLockFromISR();

  /* Disables the source but the status flags are not reset because the
     read/write functions needs to check them.*/
  SDMMC1->MASK = 0;

  osalThreadResumeI(&SDCD1.thread, MSG_OK);

  osalSysUnlockFromISR();

  OSAL_IRQ_EPILOGUE();
}
#endif

/**
 * @brief   SDMMC2 IRQ handler.
 * @details It just wakes transaction thread, errors handling is performed in
 *          there.
 *
 * @isr
 */
#if STM32_SDC_USE_SDMMC2 || defined(__DOXYGEN__)
OSAL_IRQ_HANDLER(STM32_SDMMC2_HANDLER) {

  OSAL_IRQ_PROLOGUE();

  osalSysLockFromISR();

  /* Disables the source but the status flags are not reset because the
     read/write functions needs to check them.*/
  SDMMC2->MASK = 0;

  osalThreadResumeI(&SDCD2.thread, MSG_OK);

  osalSysUnlockFromISR();

  OSAL_IRQ_EPILOGUE();
}
#endif

/*===========================================================================*/
/* Driver exported functions.                                                */
/*===========================================================================*/

/**
 * @brief   Low level SDC driver initialization.
 *
 * @notapi
 */
void sdc_lld_init(void) {

#if STM32_SDC_USE_SDMMC1
  sdcObjectInit(&SDCD1);
  SDCD1.thread = NULL;
  SDCD1.rtmo   = SDMMC1_READ_TIMEOUT;
  SDCD1.wtmo   = SDMMC1_WRITE_TIMEOUT;
  SDCD1.dma    = NULL;
  SDCD1.sdmmc  = SDMMC1;
  nvicEnableVector(STM32_SDMMC1_NUMBER, STM32_SDC_SDMMC1_IRQ_PRIORITY);
#endif

#if STM32_SDC_USE_SDMMC2
  sdcObjectInit(&SDCD2);
  SDCD2.thread = NULL;
  SDCD2.rtmo   = SDMMC2_READ_TIMEOUT;
  SDCD2.wtmo   = SDMMC2_WRITE_TIMEOUT;
  SDCD2.dma    = NULL;
  SDCD2.sdmmc  = SDMMC2;
  nvicEnableVector(STM32_SDMMC2_NUMBER, STM32_SDC_SDMMC2_IRQ_PRIORITY);
#endif
}

/**
 * @brief   Configures and activates the SDC peripheral.
 *
 * @param[in] sdcp      pointer to the @p SDCDriver object
 *
 * @notapi
 */
void sdc_lld_start(SDCDriver *sdcp) {

  /* Checking configuration, using a default if NULL has been passed.*/
  if (sdcp->config == NULL) {
    sdcp->config = &sdc_default_cfg;
  }

  sdcp->dmamode = STM32_DMA_CR_PSIZE_WORD |
                  STM32_DMA_CR_MSIZE_WORD |
                  STM32_DMA_CR_MINC;

#if STM32_DMA_ADVANCED
  sdcp->dmamode |= STM32_DMA_CR_PFCTRL |
                   STM32_DMA_CR_PBURST_INCR4 |
                   STM32_DMA_CR_MBURST_INCR4;
#endif

  /* If in stopped state then clocks are enabled and DMA initialized.*/
  if (sdcp->state == BLK_STOP) {
#if STM32_SDC_USE_SDMMC1
    if (&SDCD1 == sdcp) {
      sdcp->dma = dmaStreamAllocI(STM32_SDC_SDMMC1_DMA_STREAM,
                                  STM32_SDC_SDMMC1_IRQ_PRIORITY,
                                  NULL,
                                  NULL);
      osalDbgAssert(sdcp->dma != NULL, "unable to allocate stream");

      sdcp->dmamode |= STM32_DMA_CR_CHSEL(SDMMC1_DMA_CHANNEL) |
                       STM32_DMA_CR_PL(STM32_SDC_SDMMC1_DMA_PRIORITY);
      dmaStreamSetPeripheral(sdcp->dma, &sdcp->sdmmc->FIFO);
#if STM32_DMA_ADVANCED
      dmaStreamSetFIFO(sdcp->dma, STM32_DMA_FCR_DMDIS |
                                  STM32_DMA_FCR_FTH_FULL);
#endif
      rccEnableSDMMC1(true);
    }
#endif /* STM32_SDC_USE_SDMMC1 */

#if STM32_SDC_USE_SDMMC2
    if (&SDCD2 == sdcp) {
      sdcp->dma = dmaStreamAllocI(STM32_SDC_SDMMC2_DMA_STREAM,
                                  STM32_SDC_SDMMC2_IRQ_PRIORITY,
                                  NULL,
                                  NULL);
      osalDbgAssert(sdcp->dma != NULL, "unable to allocate stream");

      sdcp->dmamode |= STM32_DMA_CR_CHSEL(SDMMC2_DMA_CHANNEL) |
                       STM32_DMA_CR_PL(STM32_SDC_SDMMC2_DMA_PRIORITY);
      dmaStreamSetPeripheral(sdcp->dma, &sdcp->sdmmc->FIFO);
#if STM32_DMA_ADVANCED
      dmaStreamSetFIFO(sdcp->dma, STM32_DMA_FCR_DMDIS |
                                  STM32_DMA_FCR_FTH_FULL);
#endif
      rccEnableSDMMC2(true);
    }
#endif /* STM32_SDC_USE_SDMMC2 */
  }

  /* Configuration, card clock is initially stopped.*/
  sdcp->sdmmc->POWER  = 0;
  sdcp->sdmmc->CLKCR  = 0;
  sdcp->sdmmc->DCTRL  = 0;
  sdcp->sdmmc->DTIMER = 0;
}

/**
 * @brief   Deactivates the SDC peripheral.
 *
 * @param[in] sdcp      pointer to the @p SDCDriver object
 *
 * @notapi
 */
void sdc_lld_stop(SDCDriver *sdcp) {

  if (sdcp->state != BLK_STOP) {

    /* SDIO deactivation.*/
    sdcp->sdmmc->POWER  = 0;
    sdcp->sdmmc->CLKCR  = 0;
    sdcp->sdmmc->DCTRL  = 0;
    sdcp->sdmmc->DTIMER = 0;

    /* DMA stream released.*/
    dmaStreamFreeI(sdcp->dma);
    sdcp->dma = NULL;

    /* Clock deactivation.*/
#if STM32_SDC_USE_SDMMC1
    if (&SDCD1 == sdcp) {
      rccDisableSDMMC1();
    }
#endif

#if STM32_SDC_USE_SDMMC2
    if (&SDCD2 == sdcp) {
      rccDisableSDMMC2();
    }
#endif
  }
}

/**
 * @brief   Starts the SDIO clock and sets it to init mode (400kHz or less).
 *
 * @param[in] sdcp      pointer to the @p SDCDriver object
 *
 * @notapi
 */
void sdc_lld_start_clk(SDCDriver *sdcp) {

  /* Initial clock setting: 400kHz, 1bit mode.*/
  sdcp->sdmmc->CLKCR  = SDMMC_CLKDIV_LS;
  sdcp->sdmmc->POWER |= SDMMC_POWER_PWRCTRL_0 | SDMMC_POWER_PWRCTRL_1;
  sdcp->sdmmc->CLKCR |= SDMMC_CLKCR_CLKEN;

  /* Clock activation delay.*/
  osalThreadSleep(OSAL_MS2I(STM32_SDC_SDMMC_CLOCK_DELAY));
}

/**
 * @brief   Sets the SDIO clock to data mode (25/50 MHz or less).
 *
 * @param[in] sdcp      pointer to the @p SDCDriver object
 * @param[in] clk       the clock mode
 *
 * @notapi
 */
void sdc_lld_set_data_clk(SDCDriver *sdcp, sdcbusclk_t clk) {

#if STM32_SDC_SDMMC_50MHZ
  if (SDC_CLK_50MHz == clk) {
    sdcp->sdmmc->CLKCR = (sdcp->sdmmc->CLKCR & 0xFFFFFF00U) |
#if STM32_SDC_SDMMC_PWRSAV
                         SDMMC_CLKDIV_HS | SDMMC_CLKCR_BYPASS |
                         SDMMC_CLKCR_PWRSAV;
#else
                         SDMMC_CLKDIV_HS | SDMMC_CLKCR_BYPASS;
#endif
  }
  else {
#if STM32_SDC_SDMMC_PWRSAV
    sdcp->sdmmc->CLKCR = (sdcp->sdmmc->CLKCR & 0xFFFFFF00U) | SDMMC_CLKDIV_HS |
                         SDMMC_CLKCR_PWRSAV;
#else
    sdcp->sdmmc->CLKCR = (sdcp->sdmmc->CLKCR & 0xFFFFFF00U) | SDMMC_CLKDIV_HS;
#endif
  }
#else
  (void)clk;

#if STM32_SDC_SDMMC_PWRSAV
  sdcp->sdmmc->CLKCR = (sdcp->sdmmc->CLKCR & 0xFFFFFF00U) | SDMMC_CLKDIV_HS |
                       SDMMC_CLKCR_PWRSAV;
#else
  sdcp->sdmmc->CLKCR = (sdcp->sdmmc->CLKCR & 0xFFFFFF00U) | SDMMC_CLKDIV_HS;
#endif
#endif
}

/**
 * @brief   Stops the SDIO clock.
 *
 * @param[in] sdcp      pointer to the @p SDCDriver object
 *
 * @notapi
 */
void sdc_lld_stop_clk(SDCDriver *sdcp) {

  sdcp->sdmmc->CLKCR = 0;
  sdcp->sdmmc->POWER = 0;
}

/**
 * @brief   Switches the bus to 1, 4 or 8 bits mode.
 *
 * @param[in] sdcp      pointer to the @p SDCDriver object
 * @param[in] mode      bus mode
 *
 * @notapi
 */
void sdc_lld_set_bus_mode(SDCDriver *sdcp, sdcbusmode_t mode) {
  uint32_t clk = sdcp->sdmmc->CLKCR & ~SDMMC_CLKCR_WIDBUS;

  switch (mode) {
  case SDC_MODE_1BIT:
    sdcp->sdmmc->CLKCR = clk;
    break;
  case SDC_MODE_4BIT:
    sdcp->sdmmc->CLKCR = clk | SDMMC_CLKCR_WIDBUS_0;
    break;
  case SDC_MODE_8BIT:
    sdcp->sdmmc->CLKCR = clk | SDMMC_CLKCR_WIDBUS_1;
    break;
  }
}

/**
 * @brief   Sends an SDIO command with no response expected.
 *
 * @param[in] sdcp      pointer to the @p SDCDriver object
 * @param[in] cmd       card command
 * @param[in] arg       command argument
 *
 * @notapi
 */
void sdc_lld_send_cmd_none(SDCDriver *sdcp, uint8_t cmd, uint32_t arg) {

  sdcp->sdmmc->ARG = arg;
  sdcp->sdmmc->CMD = (uint32_t)cmd | SDMMC_CMD_CPSMEN;
  while ((sdcp->sdmmc->STA & SDMMC_STA_CMDSENT) == 0)
    ;
  sdcp->sdmmc->ICR = SDMMC_ICR_CMDSENTC;
}
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
