Kreyl/HogwartsFlasks/(commit log)

2019-08-31 + Sch seems done
    [HogwartsFlasksMain.kicad_pcb, HogwartsFlasksMain.sch]
2019-09-04 PCB Layout done
    [HogwartsFlasksMain.kicad_pcb, HogwartsFlasksMain.sch]
2019-09-23 PCB tracing started
    [HogwartsFlasksMain.dsn]
2019-09-28 Proceeding with tracing
    [HogwartsFlasksMain.dsn, HogwartsFlasksMain.kicad_pcb, HogwartsFlasksMain.sch]
2019-09-29 PCB sent to factory
    [HogwartsFlasksMain.kicad_pcb, HogwartsFlasksMain.sch]
2019-10-09 BOM added
    [FlasksMainBOM 0110.csv]
2019-10-13 UART works ok
2019-10-13 + LED works
2019-11-03 MainPCB: Usb does not work somehow
    [EvtMsgIDs.h, board.h, halconf.h, main.cpp, mcuconf.h]
2019-11-21 * Framebuf1 successfully moved to SDRAM
2019-11-22 * Fix display clk * Display code clean-up + ColorARGB_t
    [color.h, kl_lib.cpp, lcdtft.cpp, main.cpp]
2020-04-18 * Switch to Stm32CubeIDE
2020-04-18 + Switch succeded + SDRAM works
2020-10-30 + v2: LCD connector fixed
    [HogwartsFlasksMain.kicad_sch]
2021-04-10 * Switch to newer KiCAD
    [HogwartsFlasksMain.kicad_sch]
2021-04-10 * Screen code added, not working now
    [AviDecode.cpp, AviDecode.h, CS42L52.cpp, CS42L52.h, EvtMsgIDs.h, audiotrack.h, kl_time.h, main.cpp]
2021-05-04 Before switching to LS codec code
2021-05-16 Working with Lora. TX written, but does not work.
    [Lora.cpp, Lora.h, board.h, kl_lib.cpp, main.cpp, sx1276_Settings.h]
2021-11-04 + font + Control SW
    [points.csv]
2024-04-19 Trying to switch screen to eclipse. Does not work
    [EvtMsgIDs.h, board.h, buttons.h, chconf.h, color.h, ellipsis.h]
2024-04-20 Switch from "hidden" to "shown" logic
